frederikkoopman/Micro-Movinghead/Wiki/images/Yoke_servo.png

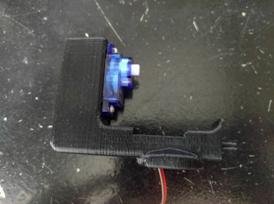
Wiki/images/Yoke_servo.png
