frederikkoopman/Micro-Movinghead/Wiki/images/PCB_connected.png

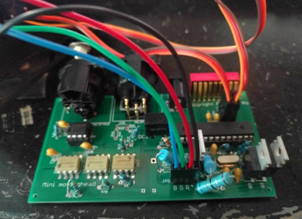
Wiki/images/PCB_connected.png
