frederikkoopman/Micro-Movinghead/README.md

# Micro-Movinghead
Open source project for a Micro Movinghead

Now also in stepper version: https://github.com/frederikkoopman/Micro-Movinghead-Stepper
