frederikkoopman/Micro-Movinghead/Code/Micro_Movinghead/readme.txt

In this directory is the Arduino code for the Micro Movinghaed.
