frederikkoopman/Micro-Movinghead/3D-models/STL-Models/readme.txt

In this directory are the STL models of all parts for the Mirco movinghead.
