frederikkoopman/Micro-Movinghead/Wiki/images/Head.png

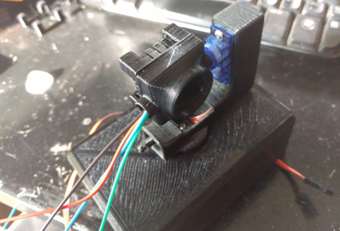
Wiki/images/Head.png
