frederikkoopman/Micro-Movinghead/Wiki/images/LED_connector.png

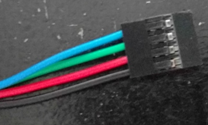
Wiki/images/LED_connector.png
