frederikkoopman/Micro-Movinghead/Wiki/images/mainbody_servo.png

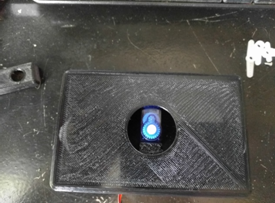
Wiki/images/mainbody_servo.png
