frederikkoopman/Micro-Movinghead/Wiki/images/Mainbody_Yoke.png

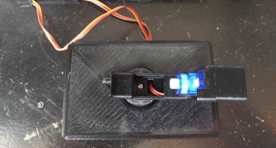
Wiki/images/Mainbody_Yoke.png
