frederikkoopman/Micro-Movinghead/Wiki/images/MH.png

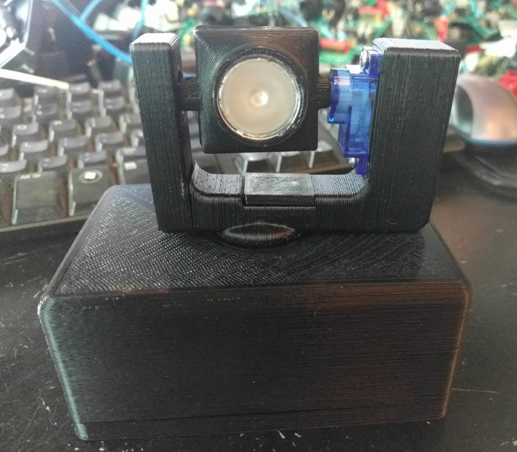
Wiki/images/MH.png
