frederikkoopman/Micro-Movinghead/Wiki/images/MH_truss.png

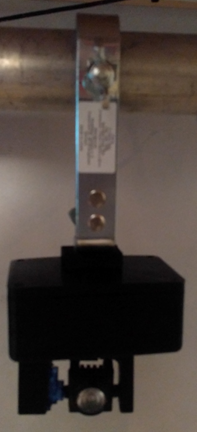
Wiki/images/MH_truss.png
