frederikkoopman/Micro-Movinghead/Wiki/images/PCB.png

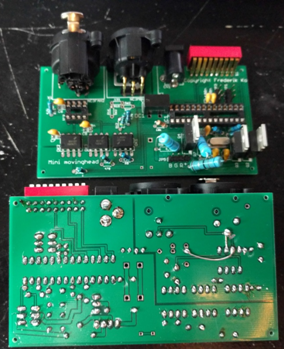
Wiki/images/PCB.png
