frederikkoopman/Micro-Movinghead/3D-models/STL-Models/mainbody_upperpart.STL

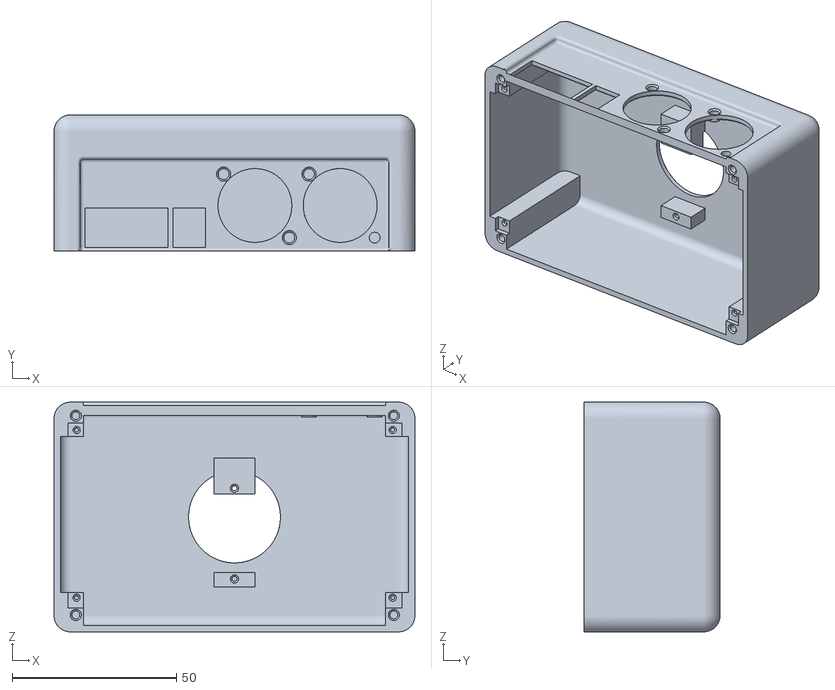
[picture p10: CAD file, 2016-09-10]
3D-models/STL-Models/mainbody_upperpart.STL
110.0 x 41.5 x 70.0
