frederikkoopman/Micro-Movinghead/3D-models/SW-Models/yoke.SLDASM

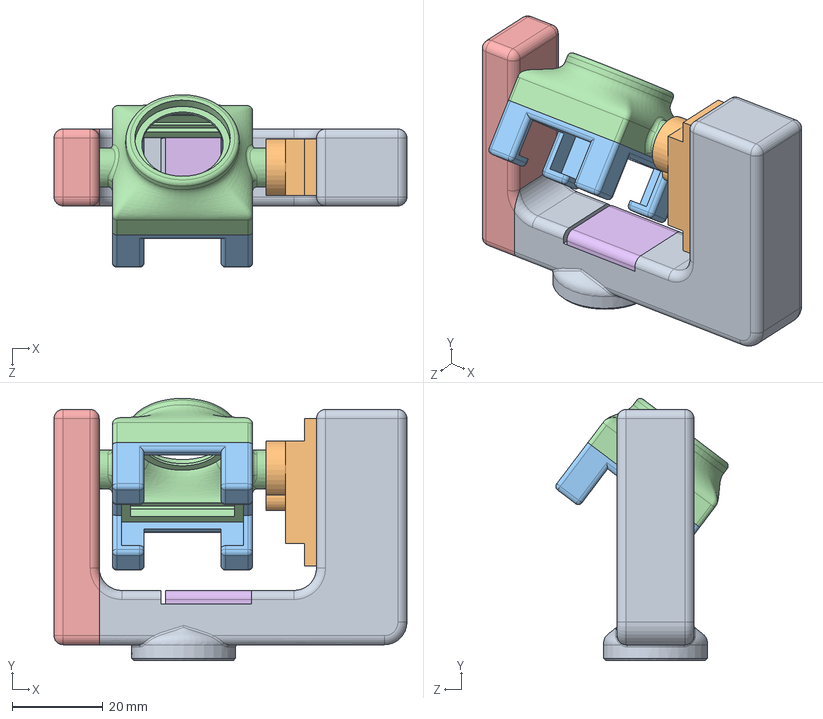
[picture p11: CAD file, 2016-09-10]
3D-models/SW-Models/yoke.SLDASM
78.0 x 57.9 x 38.1 mm
yoke_servoside
servo
heatsinkholder
ledlensholder
yoke_wireside
yokecover
