frederikkoopman/Micro-Movinghead/3D-models/SW-Models/Support_lensholder.SLDASM

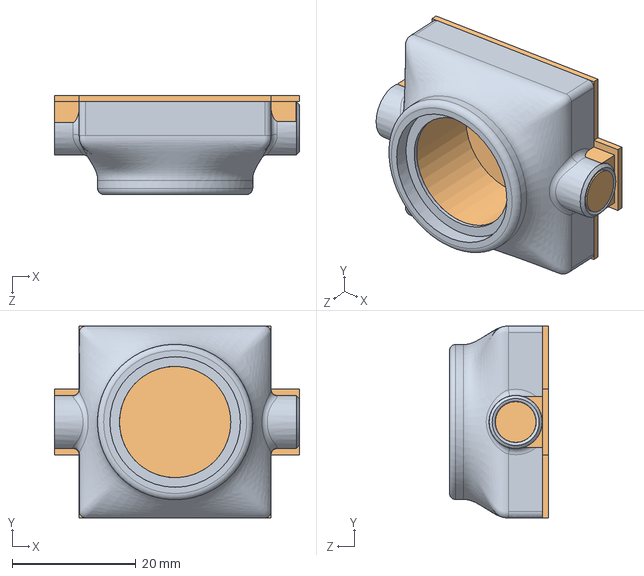
[picture p12: CAD file, 2016-09-10]
3D-models/SW-Models/Support_lensholder.SLDASM
39.6 x 31.0 x 16.0 mm
ledlensholder
lensholder_support^Assem1
