frederikkoopman/Micro-Movinghead/3D-models/SW-Models/head.SLDASM

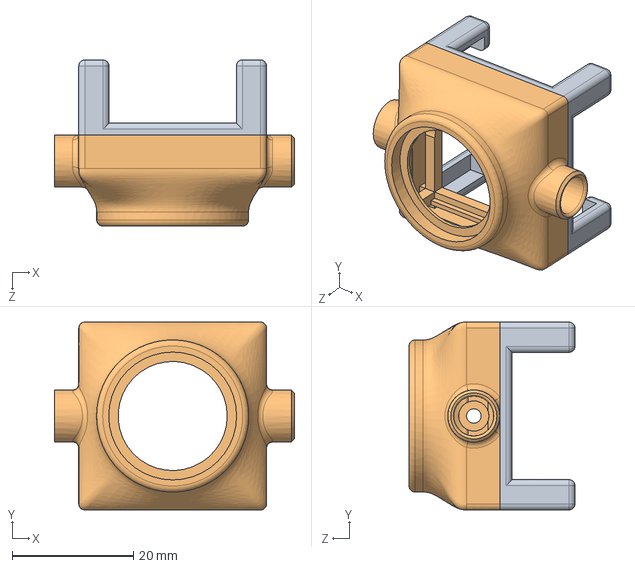
[picture p13: CAD file, 2016-09-10]
3D-models/SW-Models/head.SLDASM
39.6 x 31.0 x 27.4 mm
heatsinkholder
ledlensholder
