frederikkoopman/Micro-Movinghead/3D-models/STL-Models/mainbody_lowerpart.STL

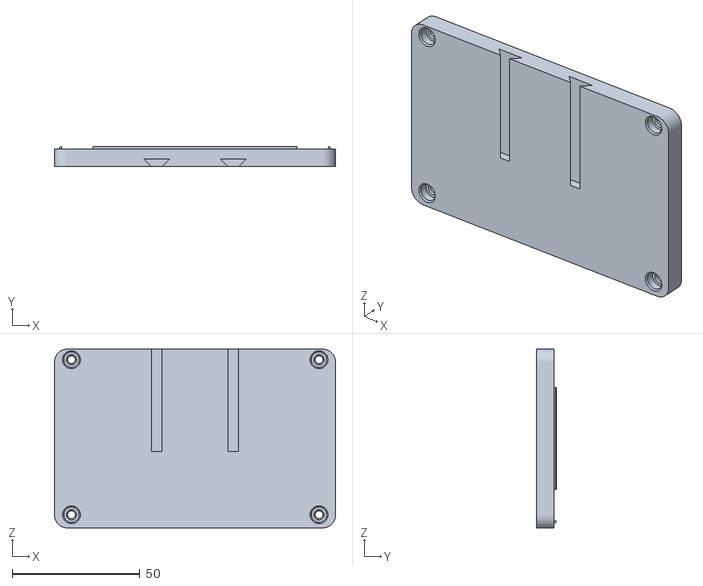
[picture p14: CAD file, 2016-09-10]
3D-models/STL-Models/mainbody_lowerpart.STL
110.0 x 8.00 x 70.0
