frederikkoopman/Micro-Movinghead/3D-models/SW-Models/mainbody_upperpart.SLDPRT

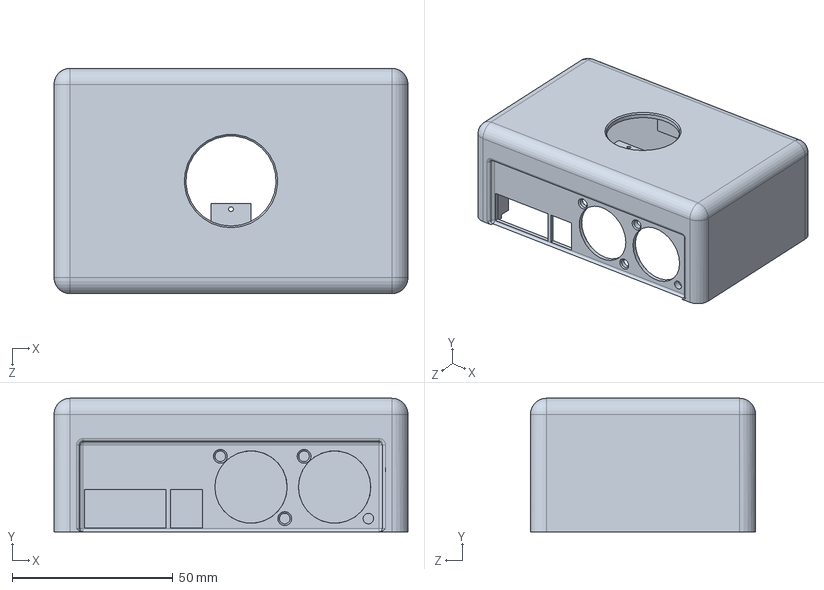
[picture p15: CAD file, 2016-09-10]
3D-models/SW-Models/mainbody_upperpart.SLDPRT
110.0 x 41.5 x 70.0 mm
