frederikkoopman/Micro-Movinghead/3D-models/SW-Models/support.SLDASM

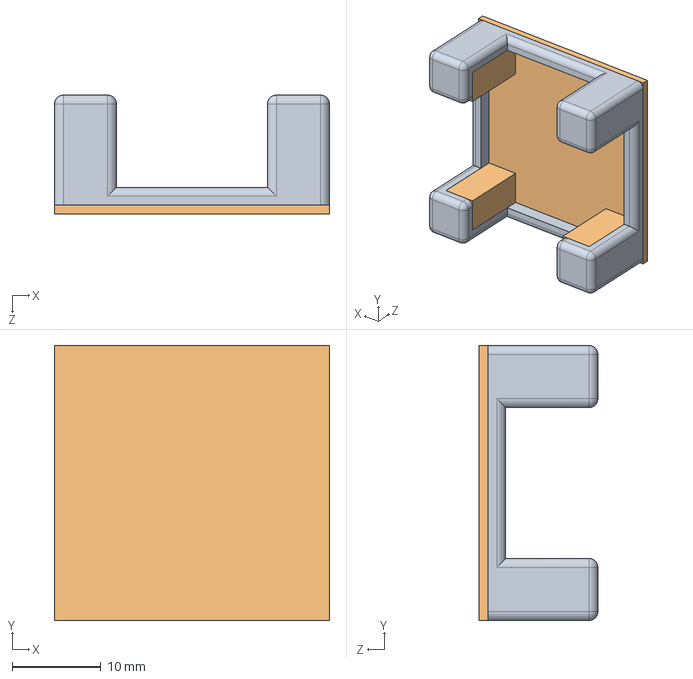
[picture p16: CAD file, 2016-09-10]
3D-models/SW-Models/support.SLDASM
31.0 x 31.0 x 13.4 mm
heatsinkholder
