frederikkoopman/Micro-Movinghead/3D-models/SW-Models/MH.SLDASM

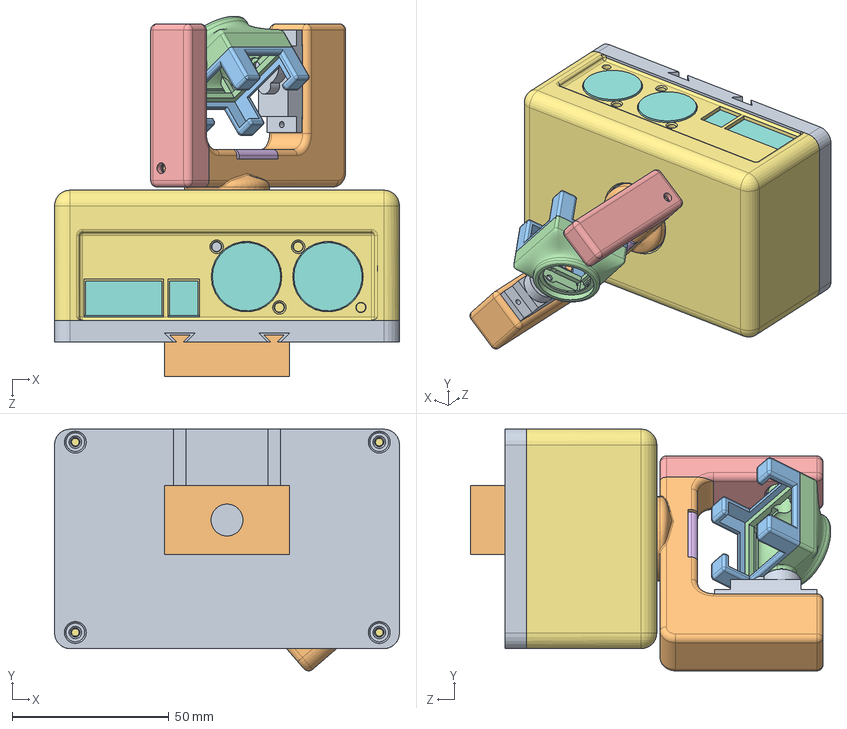
[picture p17: CAD file, 2016-09-10]
3D-models/SW-Models/MH.SLDASM
110.0 x 77.1 x 114.9 mm
servo x 2
yoke_servoside
heatsinkholder
ledlensholder
yoke_wireside
yokecover
mainbody_upperpart
pcb
mainbody_lowerpart
slideon_fastner
