frederikkoopman/Micro-Movinghead/3D-models/SW-Models/yokecover.SLDPRT

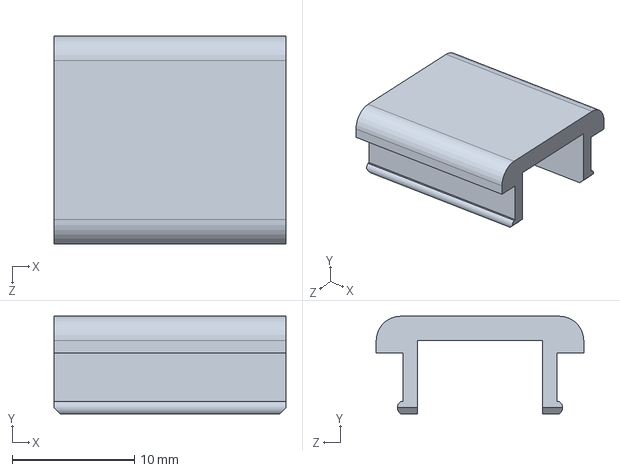
[picture p18: CAD file, 2016-09-10]
3D-models/SW-Models/yokecover.SLDPRT
19.0 x 8.00 x 17.0 mm
