frederikkoopman/Micro-Movinghead/3D-models/STL-Models/yoke_servoside.STL

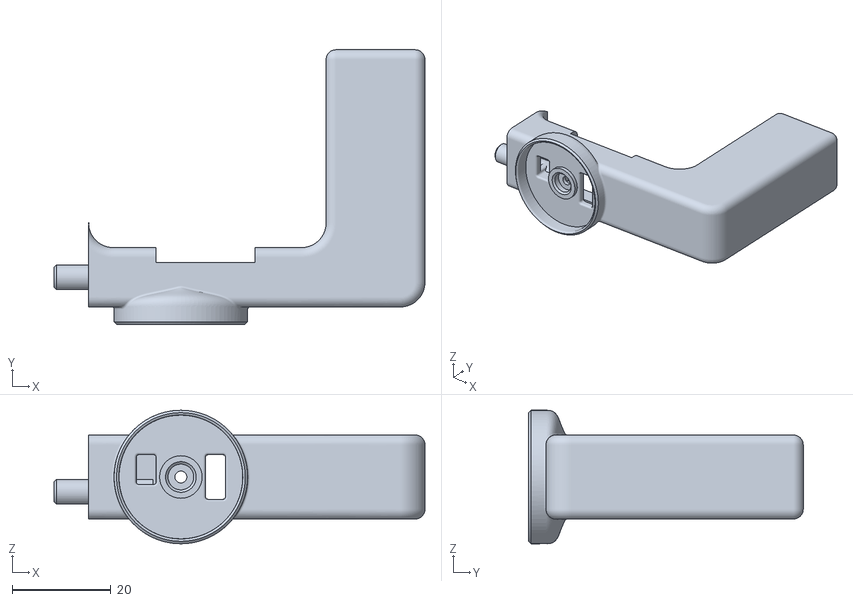
[picture p19: CAD file, 2016-09-10]
3D-models/STL-Models/yoke_servoside.STL
75.0 x 55.5 x 27.0
