frederikkoopman/Micro-Movinghead/3D-models/SW-Models/servo.SLDPRT

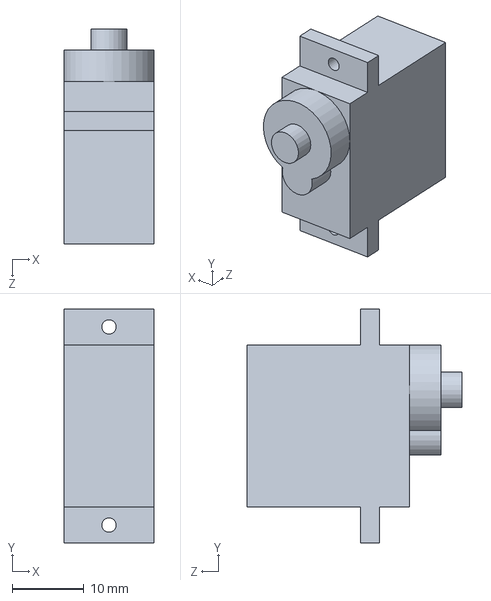
[picture p20: CAD file, 2016-09-10]
3D-models/SW-Models/servo.SLDPRT
12.5 x 32.6 x 29.9 mm
