frederikkoopman/Micro-Movinghead/3D-models/STL-Models/yoke_wireside.STL

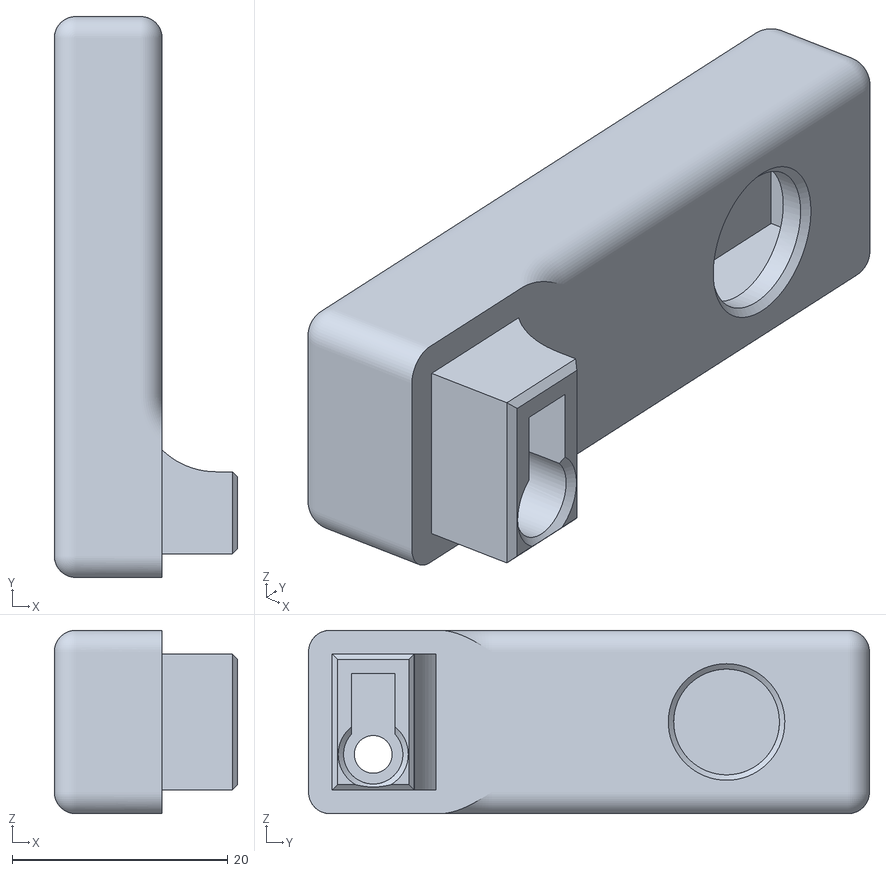
[picture p21: CAD file, 2016-09-10]
3D-models/STL-Models/yoke_wireside.STL
17.0 x 52.0 x 17.0
