frederikkoopman/Micro-Movinghead/3D-models/STL-Models/support_heatsink.STL

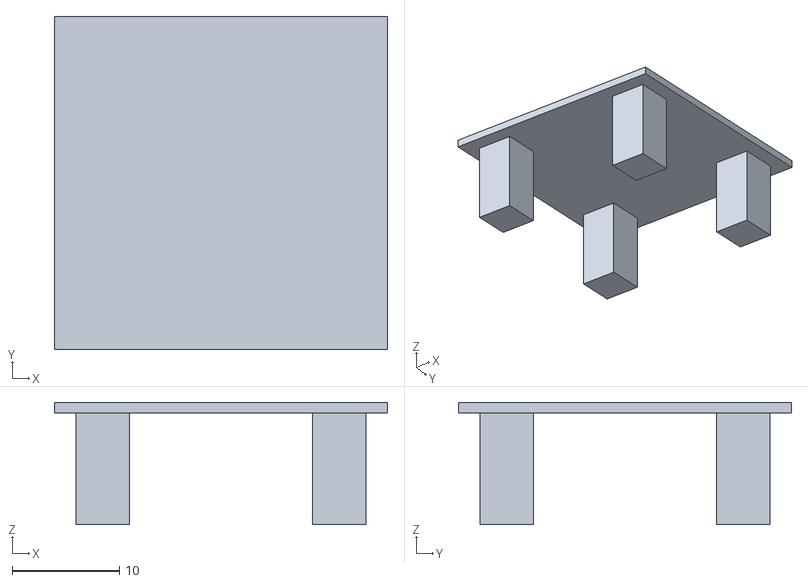
[picture p22: CAD file, 2016-09-10]
3D-models/STL-Models/support_heatsink.STL
31.0 x 31.0 x 11.4
