frederikkoopman/Micro-Movinghead/3D-models/STL-Models/heatsinkholder.STL

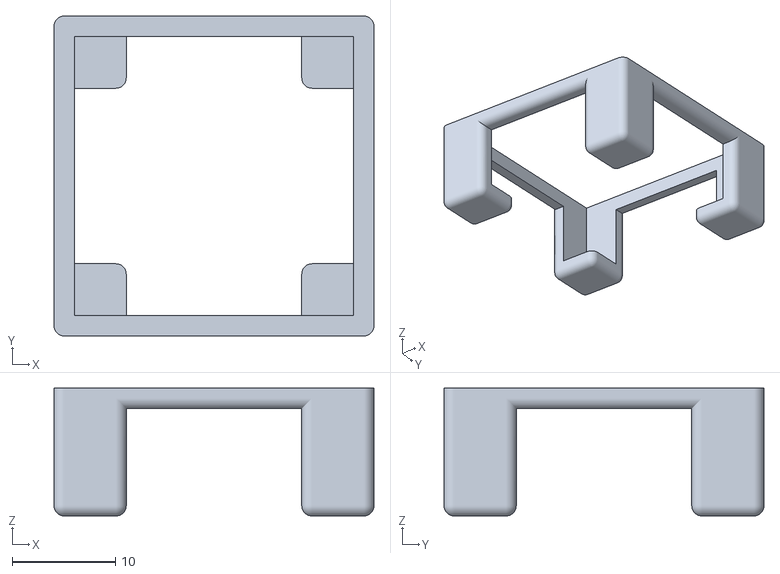
[picture p23: CAD file, 2016-09-10]
3D-models/STL-Models/heatsinkholder.STL
31.0 x 31.0 x 12.4
