frederikkoopman/Micro-Movinghead/3D-models/STL-Models/lensholder_support.STL

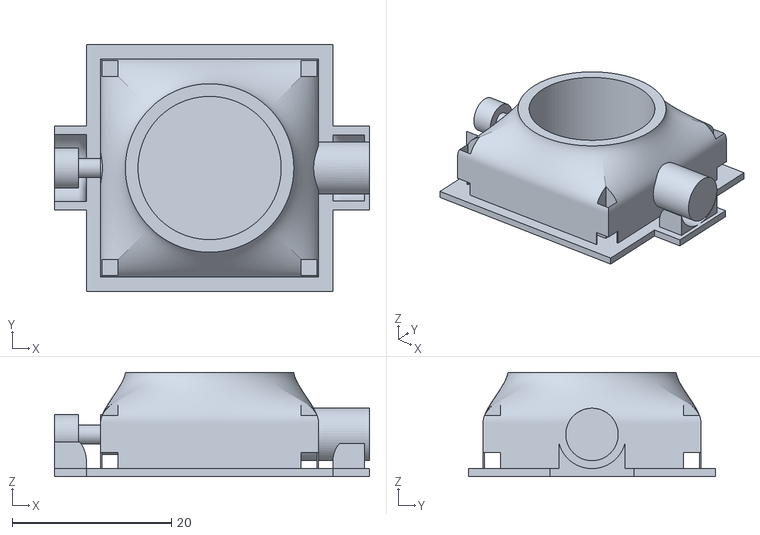
[picture p24: CAD file, 2016-09-10]
3D-models/STL-Models/lensholder_support.STL
39.6 x 31.0 x 13.1
