frederikkoopman/Micro-Movinghead/3D-models/SW-Models/slideon_fastner.SLDPRT

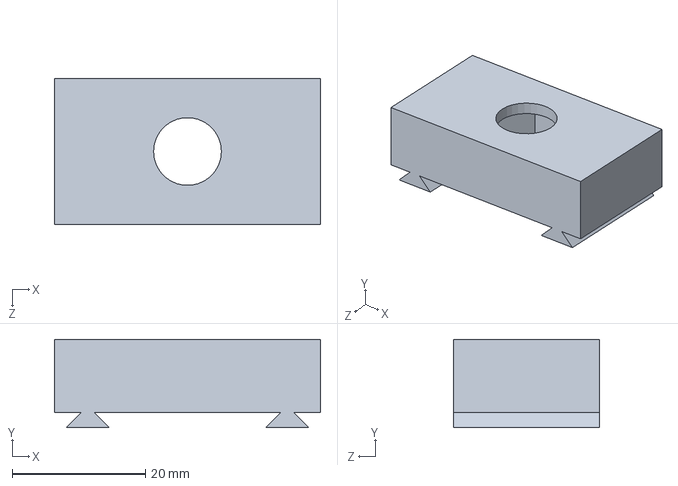
[picture p25: CAD file, 2016-09-10]
3D-models/SW-Models/slideon_fastner.SLDPRT
40.0 x 13.3 x 22.0 mm
