frederikkoopman/Micro-Movinghead/3D-models/STL-Models/ledlensholder.STL

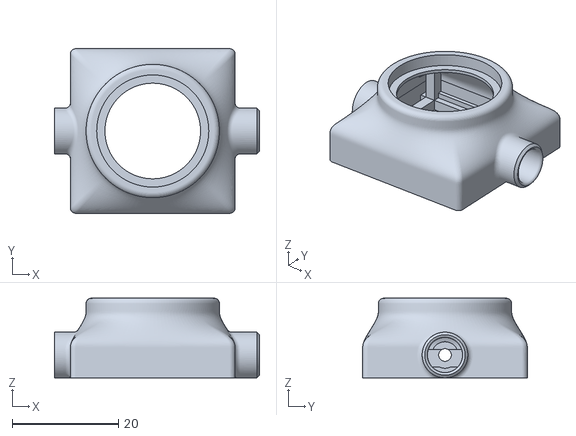
[picture p26: CAD file, 2016-09-10]
3D-models/STL-Models/ledlensholder.STL
38.6 x 31.0 x 15.0
