frederikkoopman/Micro-Movinghead/3D-models/SW-Models/pcb.SLDPRT

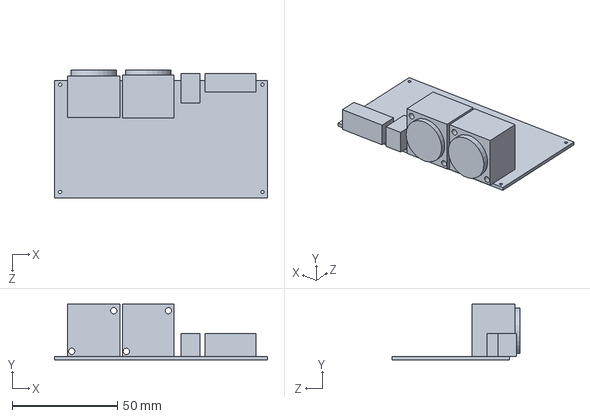
[picture p27: CAD file, 2016-09-10]
3D-models/SW-Models/pcb.SLDPRT
101.4 x 26.6 x 61.0 mm
