frederikkoopman/Micro-Movinghead/(list of files, cad)

Other CAD files:
3D-models/SW-Models/mainbody_lowerpart.SLDPRT
3D-models/SW-Models/yoke_servoside.SLDPRT
3D-models/STL-Models/slideon_fastner.STL
3D-models/STL-Models/yokecover.STL
3D-models/SW-Models/ledlensholder.SLDPRT
3D-models/SW-Models/yoke_wireside.SLDPRT
3D-models/SW-Models/heatsinkholder.SLDPRT
