frederikkoopman/Micro-Movinghead/PCB/mh.brd

## EAGLE design PCB/mh.brd (2016-09-10)

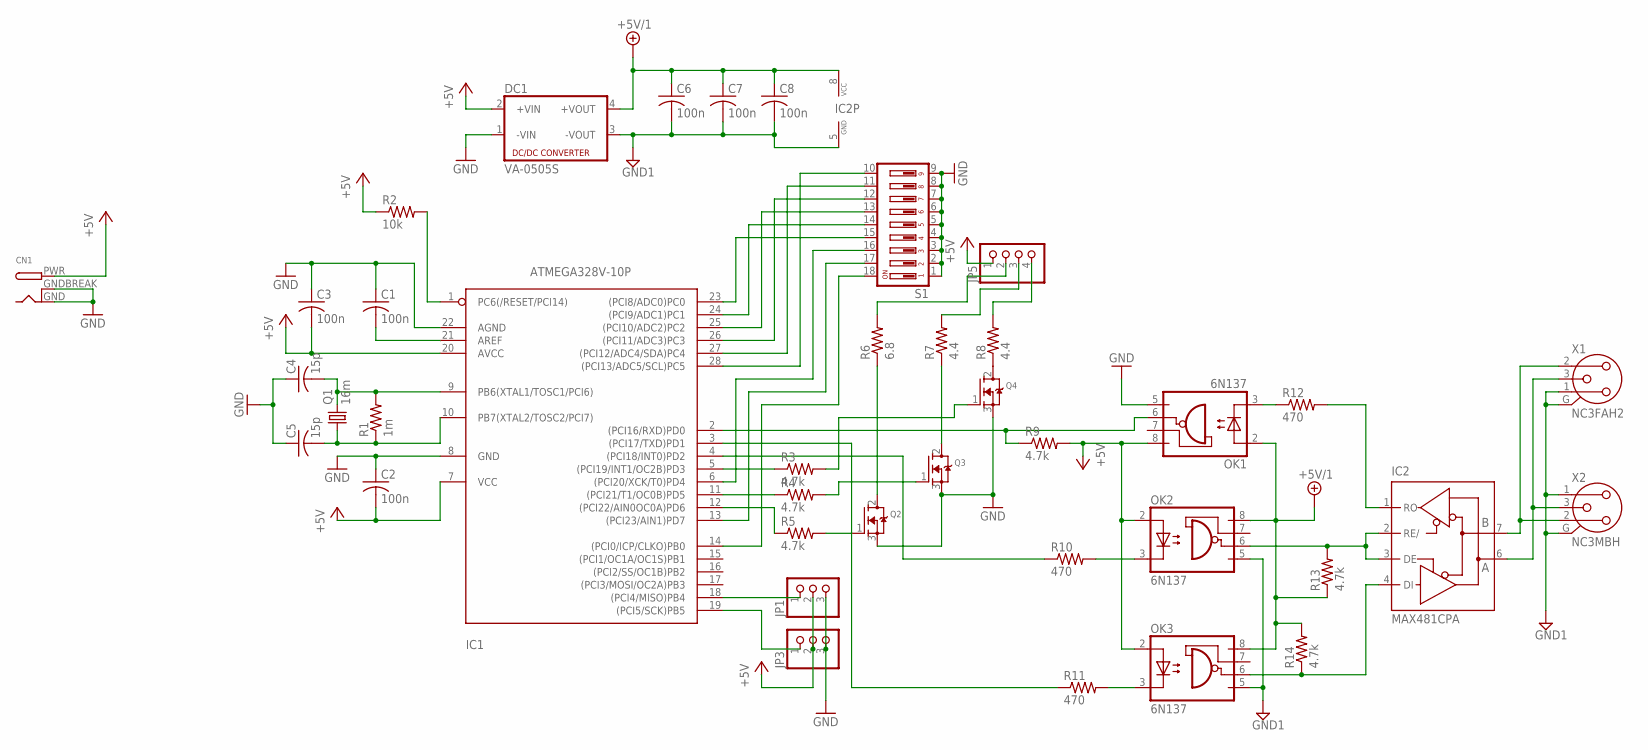
[picture p28: schematic mh.sch]

Parts:
C1, C2, C3, C6, C7, C8: 100n; C025-024X044
C4, C5: 15p; C050-024X044
CN1: DCBARRELPTH; DCJACK_2MM_PTH
DC1: VA-0505S; 4SIL
IC1: ATMEGA328V-10P; DIL28-3
IC2: MAX481CPA; DIL08
JP1, JP3: PINHD-1X3; 1X03
JP5: PINHD-1X4; 1X04
OK1, OK2, OK3: 6N137; DIL08
Q1: 16m; HC49/S
Q2, Q3, Q4: MOSFET-NGDS_TO220V; TO220V
R1: 1m; 0204/5
R2: 10k; 0204/5
R3, R4, R5, R9, R13, R14: 4.7k; 0204/5
R6: 6.8; 0207/10
R7, R8: 4.4; 0207/10
R10, R11, R12: 470; 0204/5
S1: DA09; DA-09
X1: NC3FAH2
X2: NC3MBH

Connections:
+5V: C2.2, C3.2, CN1.PWR, DC1.2 (+VIN), IC1.7 (VCC), IC1.20 (AVCC), JP1.2, JP3.2, JP5.1, OK1.8 (VCC), OK2.2 (A), OK3.2 (A), R2.1, R9.2
+5V/1: C6.1, C7.1, C8.1, DC1.4 (+VOUT), IC2.8 (VCC), OK1.2 (A), OK2.8 (VCC), OK3.8 (VCC), R13.1, R14.2
GND: C1.1, C2.1, C3.1, C4.1, C5.1, CN1.GND, CN1.GNDBREAK, DC1.1 (-VIN), IC1.8 (GND), IC1.22 (AGND), JP1.3, JP3.3, OK1.5 (GND), Q2.3 (S), Q3.3 (S), Q4.3 (S), S1.1, S1.2, S1.3, S1.4, S1.5, S1.6, S1.7, S1.8, S1.9
GND1: C6.2, C7.2, C8.2, DC1.3 (-VOUT), IC2.5 (GND), OK2.5 (GND), OK3.5 (GND), X1.1 (2), X1.G, X2.1, X2.G
unnamed: C4.2, IC1.9 (PB6(XTAL1/TOSC1/PCI6)), Q1.2, R1.2
unnamed: C5.2, IC1.10 (PB7(XTAL2/TOSC2/PCI7)), Q1.1, R1.1
unnamed: C1.2, IC1.21 (AREF)
unnamed: IC1.5 ((PCI19/INT1/OC2B)PD3), R3.1
unnamed: IC1.1 (PC6(/RESET/PCI14)), R2.2
unnamed: IC1.11 ((PCI21/T1/OC0B)PD5), R4.1
unnamed: IC1.12 ((PCI22/AIN0OC0A)PD6), R5.1
unnamed: Q2.1 (G), R5.2
unnamed: Q3.1 (G), R4.2
unnamed: Q4.1 (G), R3.2
unnamed: Q2.2 (D), R6.1
unnamed: Q3.2 (D), R7.1
unnamed: Q4.2 (D), R8.1
unnamed: JP5.4, R8.2
unnamed: JP5.3, R7.2
unnamed: JP5.2, R6.2
unnamed: IC1.23 ((PCI8/ADC0)PC0), S1.15
unnamed: IC1.28 ((PCI13/ADC5/SCL)PC5), S1.10
unnamed: IC1.27 ((PCI12/ADC4/SDA)PC4), S1.11
unnamed: IC1.24 ((PCI9/ADC1)PC1), S1.14
unnamed: IC1.26 ((PCI11/ADC3)PC3), S1.12
unnamed: IC1.25 ((PCI10/ADC2)PC2), S1.13
unnamed: IC1.14 ((PCI0/ICP/CLKO)PB0), S1.18
unnamed: IC1.13 ((PCI23/AIN1)PD7), S1.17
unnamed: IC1.6 ((PCI20/XCK/T0)PD4), S1.16
unnamed: IC1.18 ((PCI4/MISO)PB4), JP1.1
unnamed: IC1.19 ((PCI5/SCK)PB5), JP3.1
unnamed: OK2.3 (C), R10.2
unnamed: IC1.2 ((PCI16/RXD)PD0), OK1.6 (VO), R9.1
unnamed: IC1.4 ((PCI18/INT0)PD2), R10.1
unnamed: IC2.2 (RE/), IC2.3 (DE), OK2.6 (VO), R13.2
unnamed: OK3.3 (C), R11.2
unnamed: IC1.3 ((PCI17/TXD)PD1), R11.1
unnamed: IC2.4 (DI), OK3.6 (VO), R14.1
unnamed: OK1.3 (C), R12.1
unnamed: IC2.1 (RO), R12.2
unnamed: IC2.6 (A), X1.3, X2.3
unnamed: IC2.7 (B), X1.2 (1), X2.2

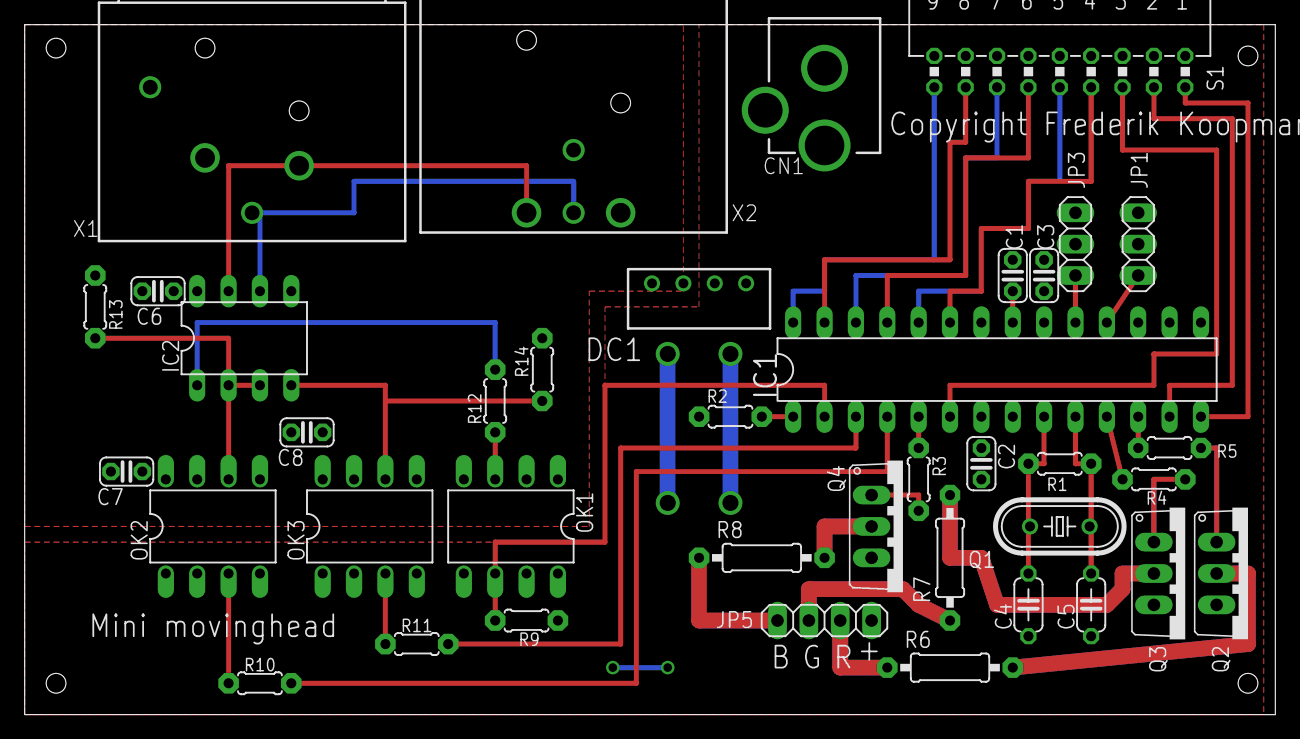
[picture p29: board mh.brd from above]

Board: 2 copper layers, 101.3 x 55.9 mm, 39 parts (0 on the bottom side), 42 nets.
