frederikkoopman/Micro-Movinghead/(threads)

Thread 2 (2016-09-10):

C3 in the wrong place

frederikkoopman, 2016-09-10:
C3 is in the wrong place. This capacitor should be placed next to OK1 instead of IC1.
