frederikkoopman/Micro-Movinghead/(notices)

Notices in the files:
PCB/mh.brd:
Copyright Frederik Koopman
